angrybear98/Linefollower/readme.md

# LineFollower

lege repository die je als template kan gebruiken om een eigen repository te starten voor uw linefollower project

A description of my image


## specifications

microcontroller: ATmega32U4

motors: 75:1 micro metal gearmotor

h-bridge: l298N

sensors: QTR-8

batteries: 18650 Li-ion

wireless communication: HC-05 bluetooth

distance sensor - motors: 180mm

weight: 350g

speed:
