angrybear98/Linefollower/code/finaal/finaal/5ba103508_hc-05-bluetooth-module_1900x950.webp

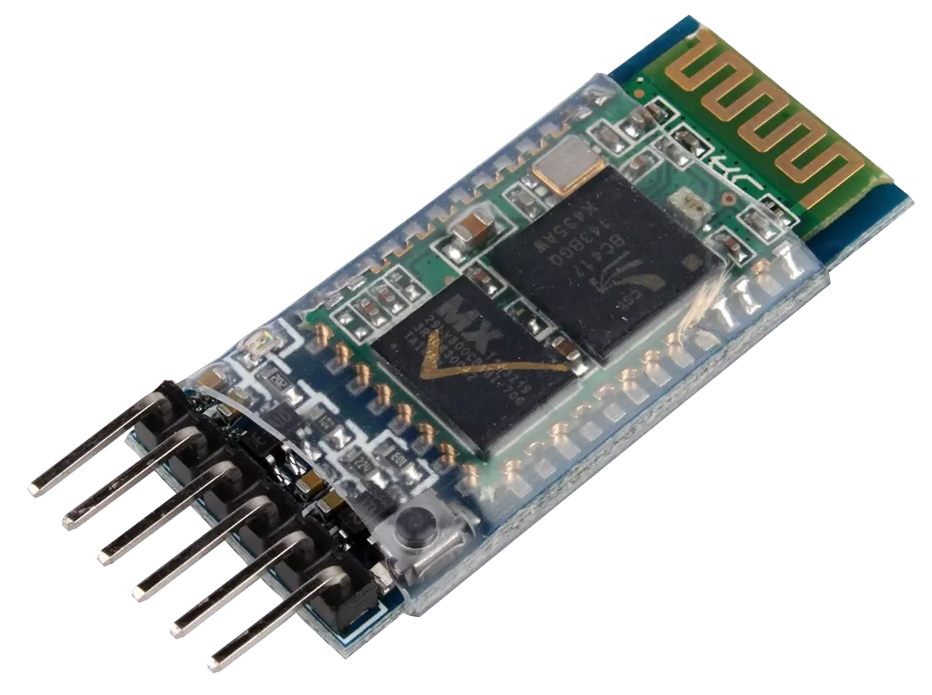
code/finaal/finaal/5ba103508_hc-05-bluetooth-module_1900x950.webp
