angrybear98/Linefollower/images/elektrisch schema.png

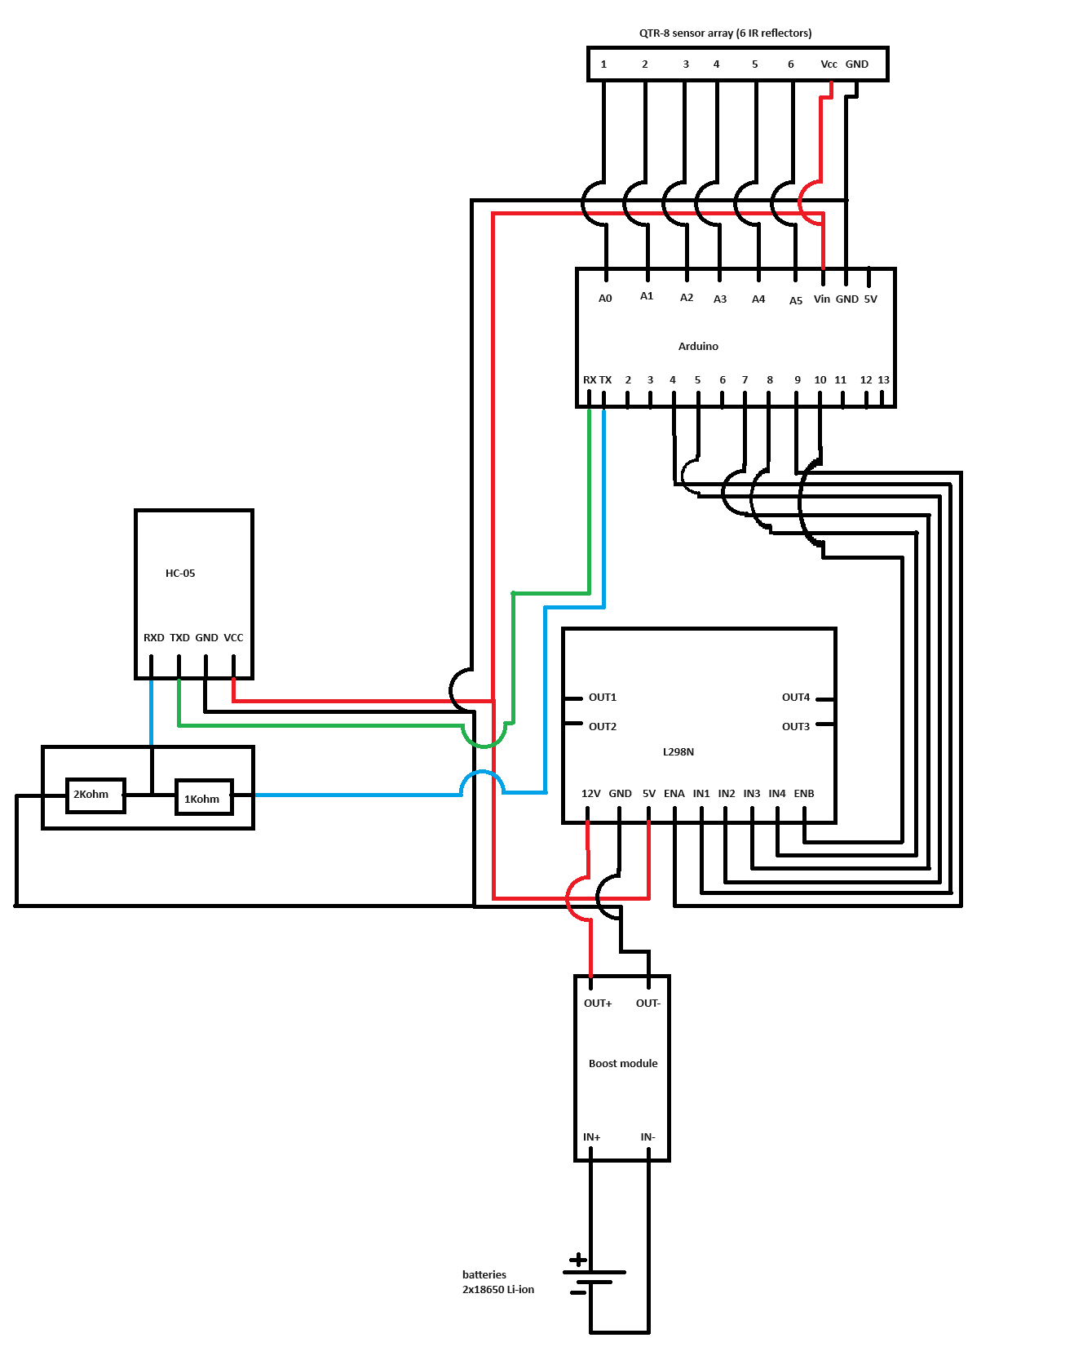
images/elektrisch schema.png
