angrybear98/Linefollower/bill of materials/readme.md

## bill of materials
<br />

## Components List

| Component | Quantity | Price per piece (euro) | URL |
|---|---|---|---|
| DC gearmotor 75:1 | 2 | 24,25 | [DC gearmotor 75:1](https://opencircuit.shop/product/751-micro-metal-gearmotor-hp-6v-extended-motor)  |
| L298N motor driver | 1 | 3,75 | [L298N motor driver](https://opencircuit.shop/product/l298n-motor-driver-module-h-bridge) |
| pololu wheel 60x8mm | 1 | 6,95 | [pololu wheel 60x8mm](https://opencircuit.shop/product/pololu-wheel-60-%C3%97-8mm-white-2-pcs) |
| arduino leonardo | 1 | 22,2 | [arduino leonardo](https://opencircuit.shop/product/arduino-leonardo-with-headers) |
| micro hearmotor brackets | 1 | 4,05 | [micro hearmotor brackets](https://opencircuit.shop/product/pololu-micro-metal-gearmotor-bracket-pair) |
| QTR-8RC sensor array | 1 | 12,95 | [QTR-8RC sensor array](https://opencircuit.shop/product/qtr-8rc-reflectance-sensor-array) |
| HC-05 bluetooth module | 1 | 5,15 | [HC-05 bluetooth module](https://opencircuit.shop/product/hc-05-bluetooth-module-met-adapter) |
| Li-ion battery 3,6V 18650 | 2 | 7,5 | [Li-ion battery 3,6V 18650](https://www.123accu.nl/XTAR-14500-batterij-3-7-V-2A-800-mAh-i49468.html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) |
| 18650 batteryholder 2x | 1 | 1 | [18650 batteryholder 2x](https://www.otronic.nl/nl/18650-batterijhouder-dubbel.html?source=googlebase&gad_source=1) |
| boost converter module | 1 | 3,5 | [boost converter module](https://opencircuit.shop/product/boost-converter-module-5v-35v-xl6009) |
| ball caster | 2 | 2,7 | [ball caster](https://opencircuit.shop/product/pololu-ball-caster-with-1-2-metal-ball) |

**Total:** 125,75 euro

## Optional Components

| Component | Quantity | Price per piece (euro) | URL |
|---|---|---|---|
| Led | 1 | 2,7 | [Led](https://opencircuit.shop/product/red-5mm-diffuse-leds-50-pcs) |
| resistor | 1 | 2,25 | [resistor](https://opencircuit.shop/product/1k%CF%89-metal-film-resistor-1-4w-100-pieces) |
| cables | 1 | 3,15 | [cables](https://opencircuit.shop/product/male-female-20-cm-band-cable-40-pieces) |
| experiment print plaat | 1 | 2,5 | [experiment print plaat](https://opencircuit.shop/product/experiment-print-6.5-cm-14.5-cm-lanes-2-pieces) |
| soldering station | 1 | 62,2 | [soldering station](https://opencircuit.shop/product/soldering-station-ceramic-heater-48w-150-420-c) |

**Total + optional:** 198,55 euro
