angrybear98/Linefollower/code/proof of concepts/start_stop/start_stop/bom.csv

Name | Quantity | Component
U1 | 1 | Arduino Uno R3
S1 | 1 | Pushbutton
R1, R2 | 2 | 1 kΩ Resistor
D1 | 1 | Red LED
