angrybear98/Linefollower/code/proof of concepts/hbridge/Copy of motor Hbrug.pdf

A

1 | 2 | 3 | 4 | 5 | 6

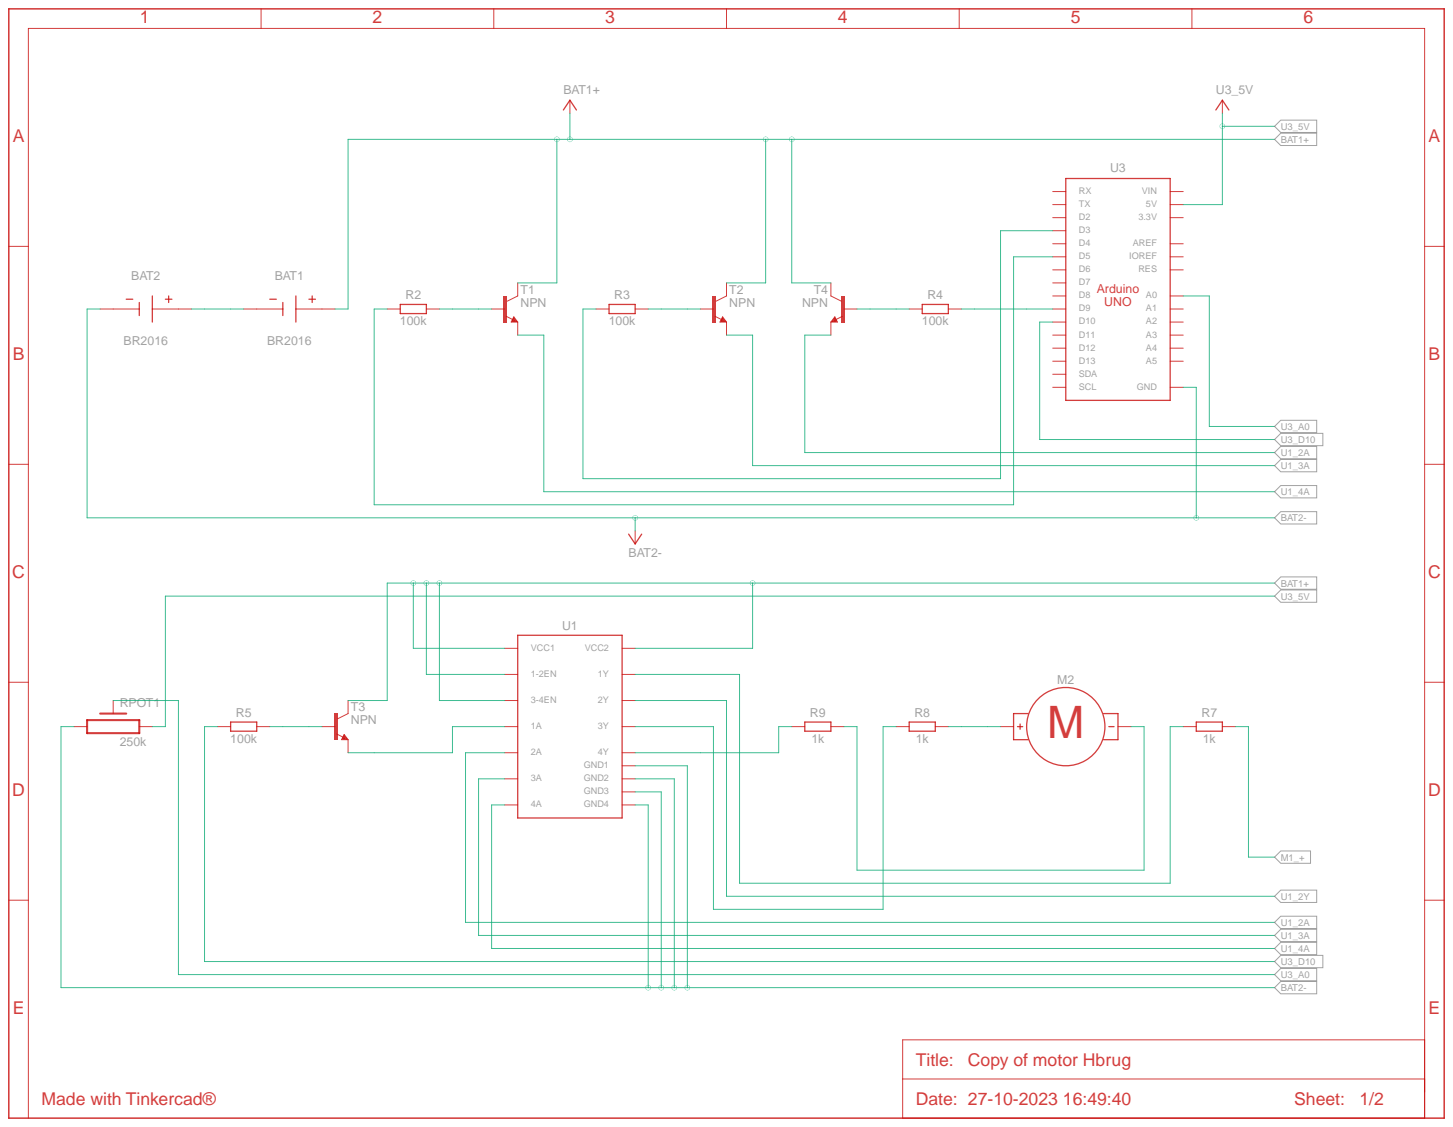
[picture p4: page 1]

Title: Copy of motor Hbrug

A

1 | 2 | 3 | 4 | 5 | 6

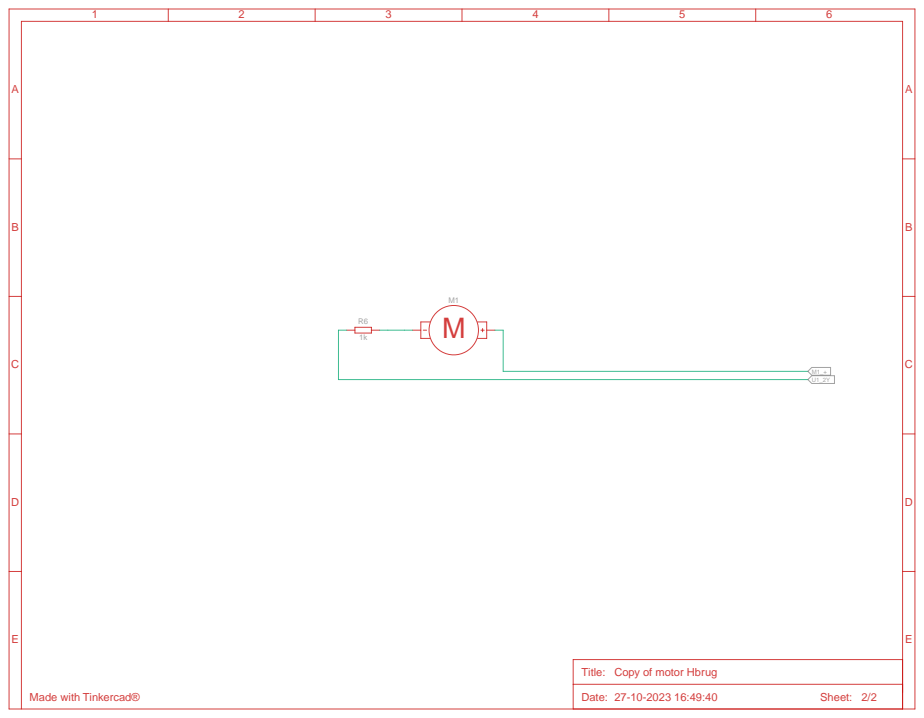
[picture p5: page 2]
Date: 27-10-2023 16:49:40; Sheet: 2/2

Title: Copy of motor Hbrug

Made with Tinkercad®
