angrybear98/Linefollower/code/proof of concepts/sensor/sensors/sensor poc.pdf

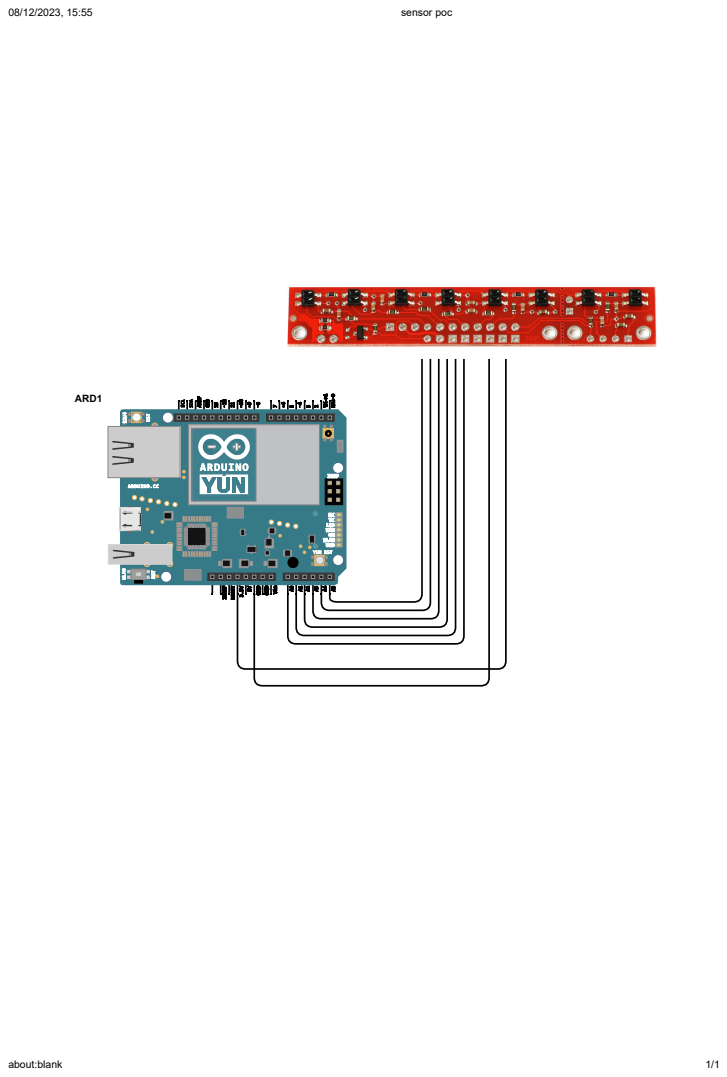
[picture p6: page 1]
sensor poc; about:blank; ARD1
