angrybear98/Linefollower/code/proof of concepts/start_stop/start_stop/start_stop.pdf

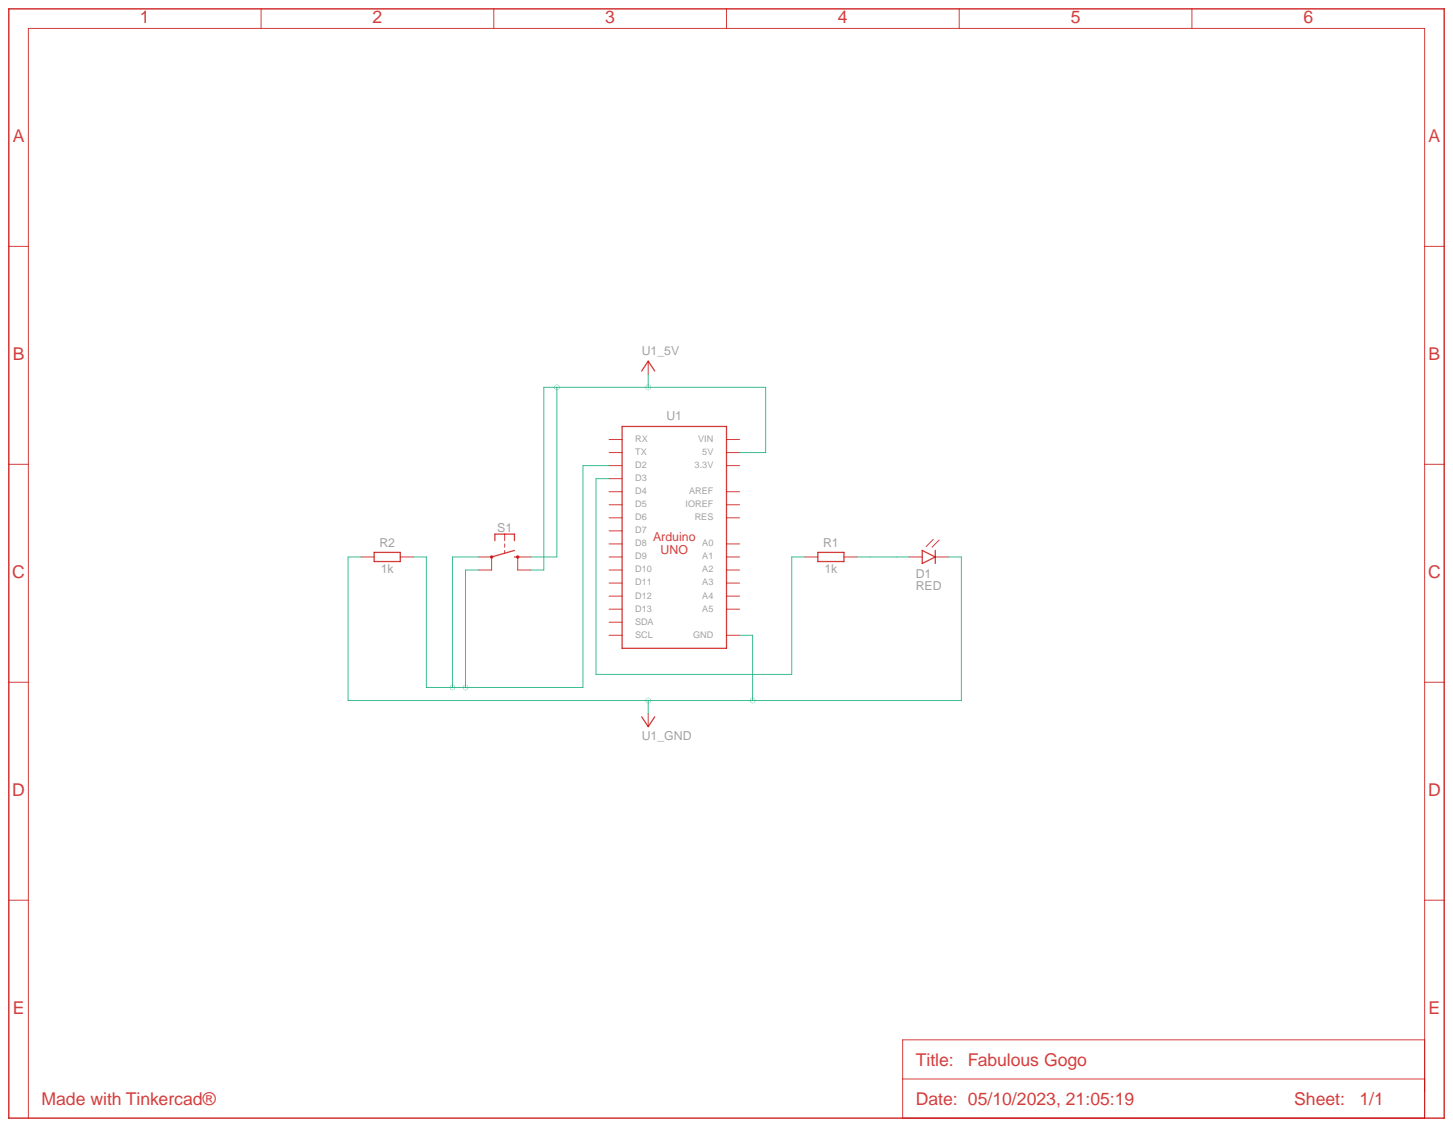
[picture p7: page 1]
