angrybear98/Linefollower/code/finaal/finaal/bluetooth poc.pdf

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

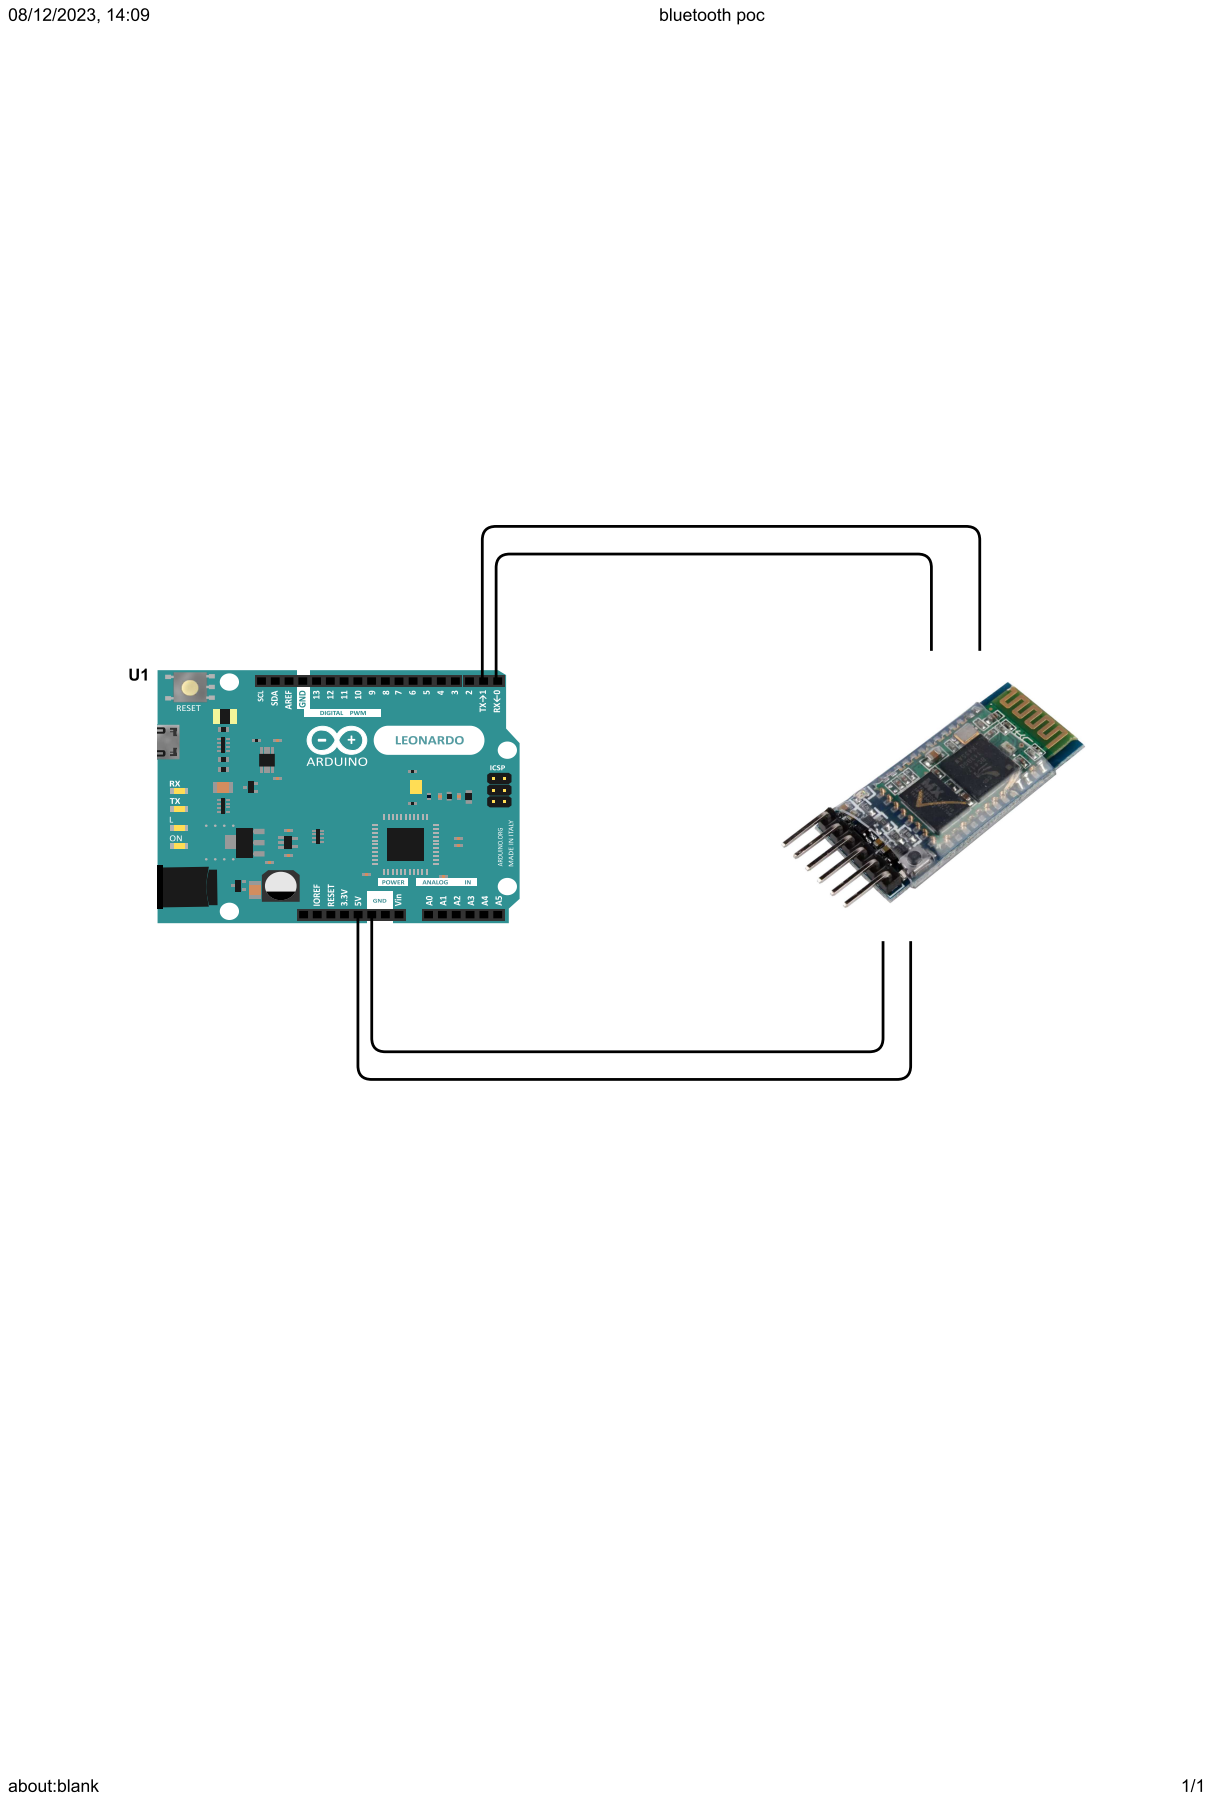
[picture p8: page 1]
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
