angrybear98/Linefollower/instructable/instructable.pdf

## Instructable

Step 1: materials
1. Order the listed items in the bill of materials, the oponal price is in case this is your first project with no prior components.
Step 2: Preparing the Power Distribuon Board

### 1. Create the Power Distribuon Point:

- Use a copper print plate to create a power distribuon point for the 5V output from the L298N.
- Solder three wire terminals for the 5V line and three for the ground line onto the print plate.
- Ensure that each terminal is securely soldered to avoid loose connecons during operaon.

### 2. Connecng to the Motor Driver:

- A*ach the 5V terminals to the 5V output of the L298N module.
- Connect the ground terminals to the GND pin of the L298N.
Step 3: Wiring the Motors

### 1. Solder the Wires to the Motors:

- Solder the wires from the L298N module to the DC micro metal gear motors. A*ach OUT1 and OUT2 to one motor and OUT3 and OUT4 to the other.
- Test the motor connecons to ensure proper rotaon direcon and funconality.

### 2. Mounng the Motors:

- A*ach the motor brackets to the robot pla2orm.
- Drill holes on the le3 and right sides of the pla2orm for mounng the motor brackets.
- Secure the motors onto the pla2orm using screws.
Step 4: Mounng the Components on the Pla#orm

### 1. Glue the Ba%ery Holders and Switch:

- Posion the ba*ery holders and the switch on the robot pla2orm where they won’t obstruct other components.
- Use hot glue or epoxy to secure them in place.

### 2. Mount the Arduino, L298N, Boost Converter, and HC-05:

- Glue the Arduino, L298N motor driver, boost converter, and HC-05 Bluetooth module onto the pla2orm. Make sure they are spaced well for easy wiring.

### 3. Install the QTR-8A Sensor Array:

- Glue the QTR-8A sensor array at the front of the pla2orm with the sensors poinng down towards the ground.
- Drill four holes at the front of the pla2orm near the sensor array to a*ach the ball rollers.
Step 5: Electrical Connecons

### 1. Power Wiring:

- Switch to Boost Converter:
- Solder the posive wire from the ba*ery pack to one terminal of the switch.
- Solder a wire from the other terminal of the switch to the posive input of the boost converter.
- Ba%ery to Boost Converter:
- Connect the negave wire from the ba*ery pack to the negave input of the boost converter.
- Boost converter calibraon:
- Measure the output of the converter with a mulmeter and turn the potenometer unl you reach 12V.
- Boost Converter to L298N:
- Connect the posive output of the boost converter to the 12V input of the L298N module.
- Connect the negave output of the boost converter to the ground terminals.

### 2. Arduino and Sensor Connecons:

- Grounding:
- Connect a wire from the common ground terminal to the GND pin of the L298N.
- From the common 5V terminal, connect a wire to the Arduino's 5V pin and another to the VCC input of the HC-05 Bluetooth module.
- Sensor Power:
- From the Arduino, connect the 5V pin to the VCC input on the QTR-8A sensor array.
- Connect the Arduino's GND pin to the GND pin on the QTR-8A sensor array.

### 3. Signal Wiring:

- HC-05 Bluetooth Module:
- Solder a voltage divider with 1kΩ and 2kΩ resistors onto a print plate.
- Connect the RX pin from the HC-05 to the input of the voltage divider.

- The 2kΩ side of the divider goes to GND, and the 1kΩ side goes to the TX port of the Arduino.
- Motor Driver Control:
- Connect Arduino digital pins 4 and 5 to IN1 and IN2 of the L298N, respecvely.
- Connect digital pins 7 and 8 to IN3 and IN4 of the L298N.
- Connect pins 9 and 10 to ENA and ENB to control motor speed via PWM.

### 4. Sensor Array Wiring:

- A*ach jumper wires from the QTR-8A sensor array to the analog inputs A0 to A5 on

the Arduino.

Step 6: Final Assembly and Tesng

### 1. Check Connecons:

- Review all connecons to ensure proper placement and secure soldering. Verify that no wires are crossing or shorng.

### 2. Power On and Test:

- Insert ba*eries into the holders and switch on the power.
- Use a mulmeter to check for correct voltage levels at various points in the circuit.
- Program the Arduino with a basic code to test motor operaon, sensor readings, and Bluetooth communicaon.

### 3. Fine-Tuning:

- If the motors are not turning in the desired direcon, reverse the wiring on the L298N outputs.
- Adjust the sensor array posion for opmal line detecon.

### 4. Programming:

- With a micro-usb you can connect to the Arduino IDE and program to the Arduino leonardo

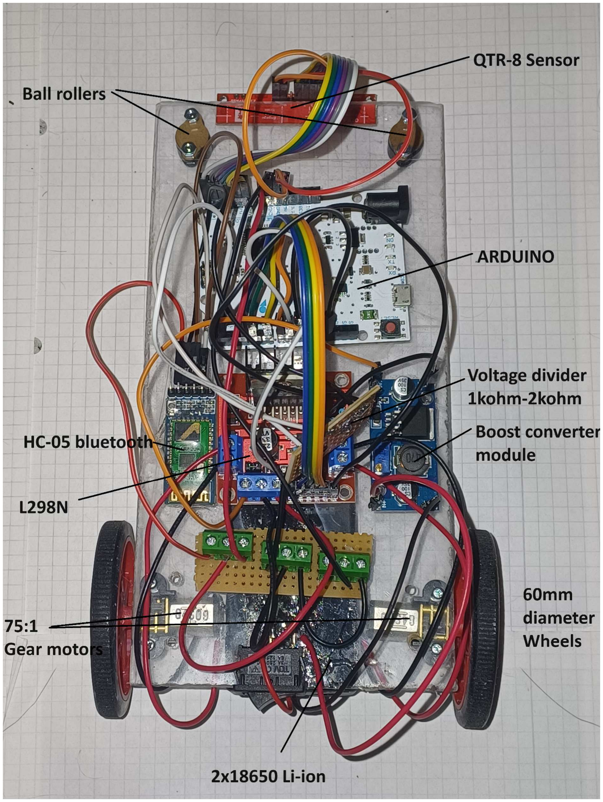
[picture p9: figure]

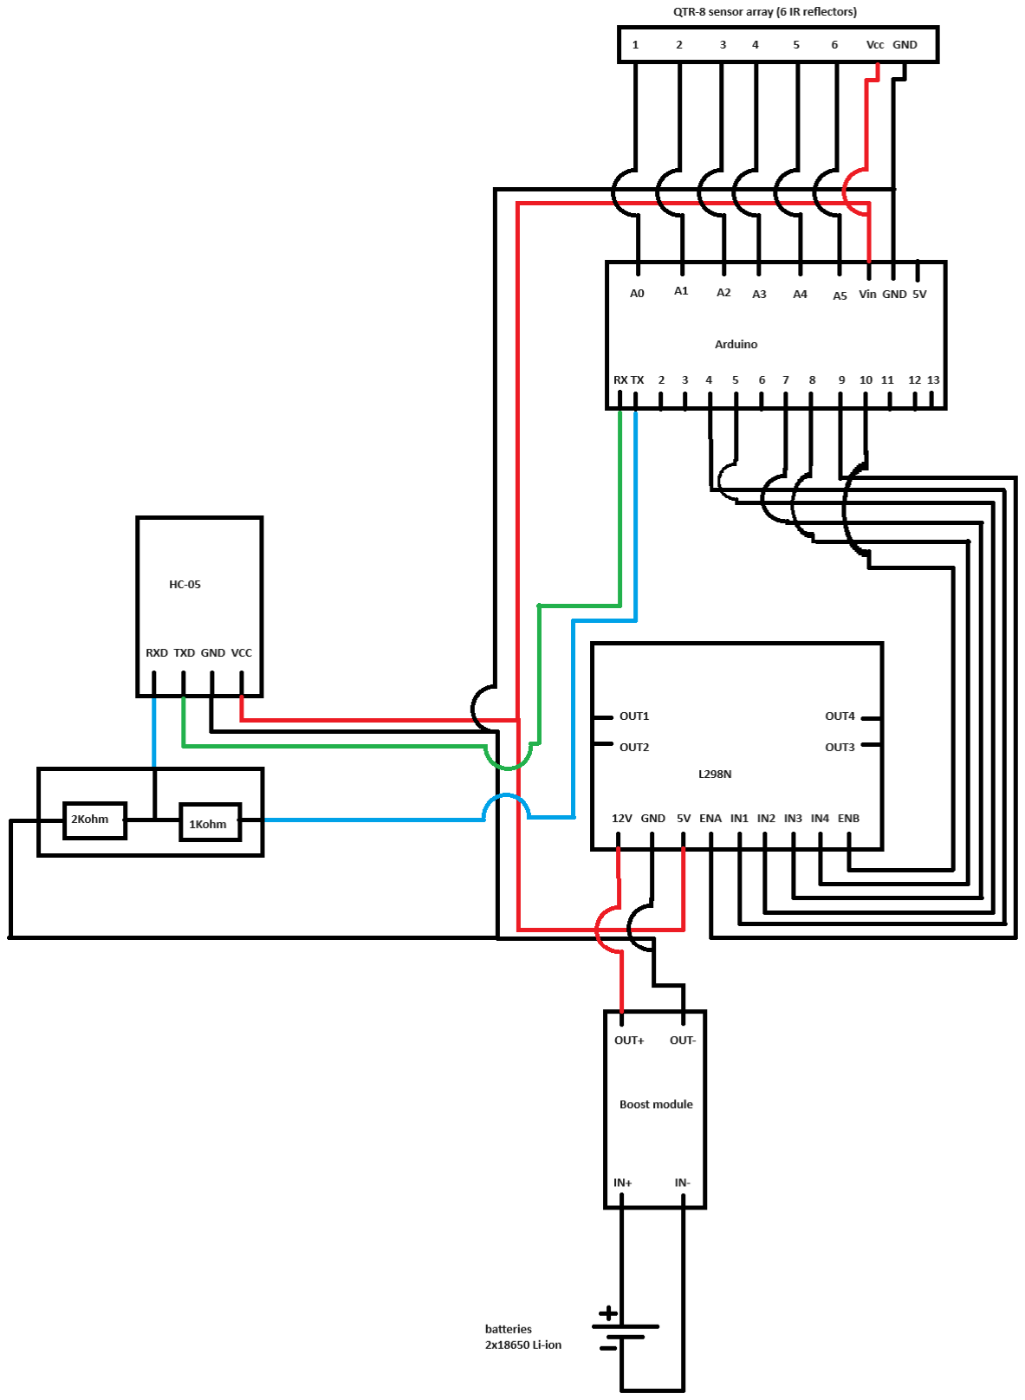
[picture p10: figure]
